ShiversVert/Snake_Project/ImageProcessing/image.jpg

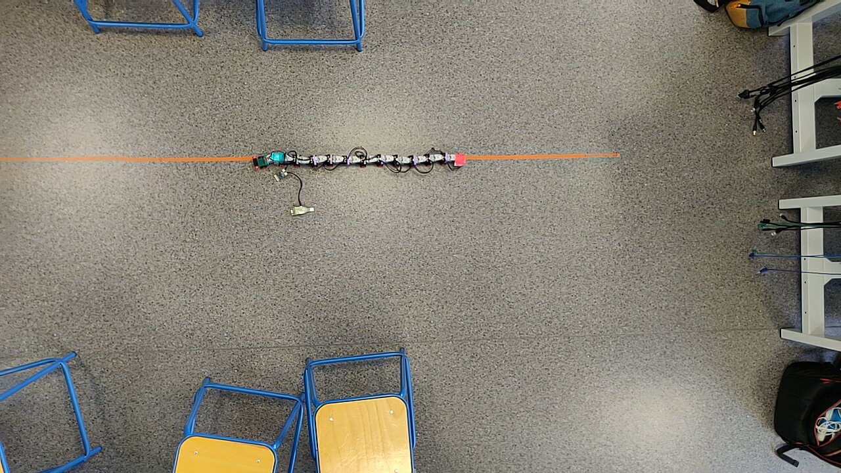
ImageProcessing/image.jpg
