ShiversVert/Snake_Project/Support_oneplus6t.stl

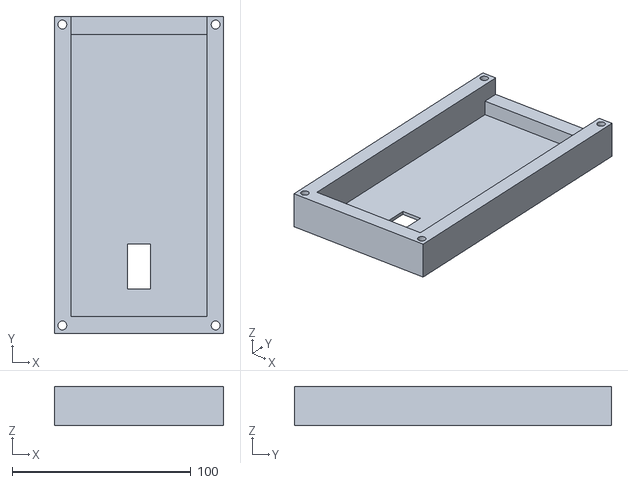
[picture p19: CAD file, 2019-05-06]
Support_oneplus6t.stl
94.8 x 177.5 x 22.0
