ShiversVert/Snake_Project/supp_tete_v2.stl

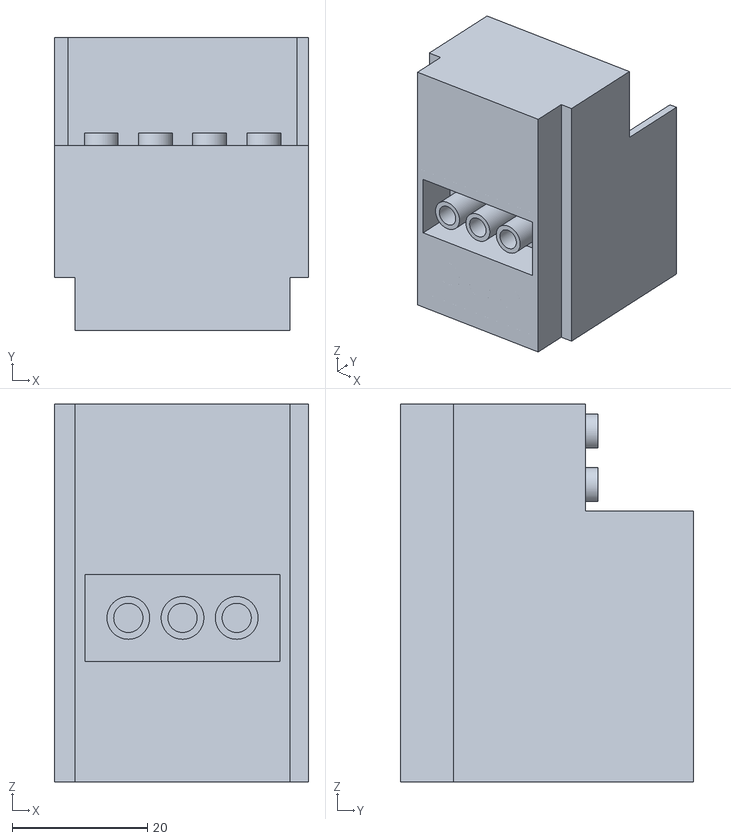
[picture p20: CAD file, 2019-05-06]
supp_tete_v2.stl
37.5 x 43.2 x 55.8
