ShiversVert/Snake_Project/piece_text_lego_v4.stl

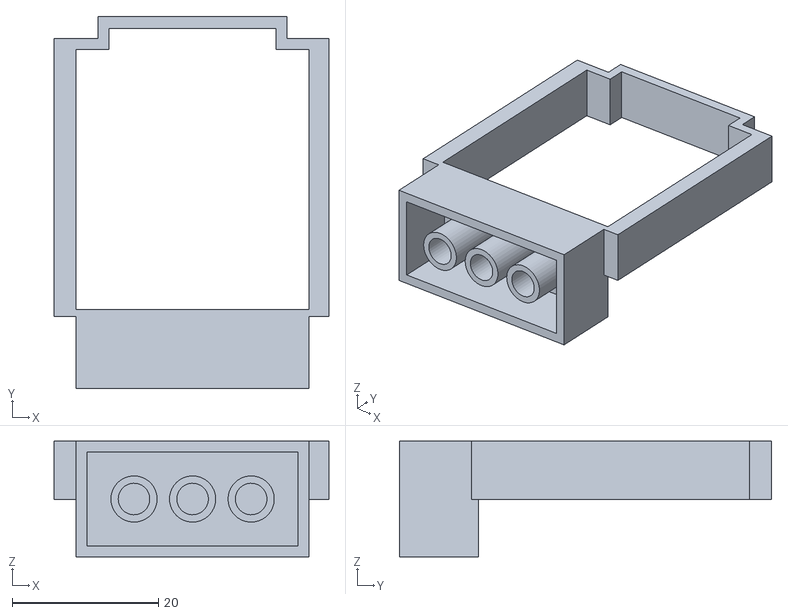
[picture p21: CAD file, 2019-05-06]
piece_text_lego_v4.stl
37.5 x 50.8 x 15.8
