ShiversVert/Snake_Project/servo_controlling/program/mapping_angle_offset.py

# -*- coding: utf-8 -*-

from time        import time, sleep
from math        import cos, sin, pi, atan
from pydynamixel import dynamixel, chain, registers

import pygame
from pygame.locals import *
"""
pygame.init()
pygame.font.init()
myfont = pygame.font.SysFont('Arial', 30)
fenetre = pygame.display.set_mode((640, 480))
"""
# TODO opti float()

# t = time()    # DEBUG
# for i in range(1000):
#     print (time() - t, "coucou{}".format(i))
#####  0.00276 sec  #####
# assert 0


############################

# You'll need to change this to the serial port of your USB2Dynamixel
serial_port = '/dev/ttyUSB0'
ser         = dynamixel.get_serial_for_url(serial_port)
# ser = dynamixel.get_serial_for_com(serial_port)    # DEBUG DEBUG


servo_id    = [1,2,3,4,5,6,7,8,9,10,11,12]

## Config servos movement ##
tick_period = 0.01              # Prediode de chaque instruction
sleep_time  = tick_period/10    # si utilisé, permet de réduire l'utilisation des
                                # ressources de la machine, mais ticks moins précis
resolution  = 500     # nombre de tick pour une période de la pos angu d'un servo
#Augmenter le resolution = ralentir

## Config snake waveform  ##
n_period    = 1     # nombre de "période" de l'ondulation du serpent
amplitude   = 300     # amplitude de l'ondulation du serpent  < 500
ANGLE_MAX   = 120     # angle crete crete max
turnOffset  = 0        # +-150

############################

move    = -1
offset  = 512+turnOffset
n_servo = len(servo_id)

# pré-calculs
mvt_speed      = 2 * pi * 1./resolution
amplitude_norm = amplitude * (float(n_period)/n_servo) * 1024./300.
omega          = 2 * pi *n_period/float(n_servo)


# enable write response
for n in range(n_servo):
    reg_value = registers.STATUS_RETURN.RETURN_FOR_ALL_PACKETS
    reg_addr  = registers.STATUS_RETURN_LEVEL  # /!\ /!\ WARNING marche uniquement sur 1 bytes !!!
                                               # goal position est sur 2 bytes !!!!
    dynamixel.set_reg_1b( ser, servo_id[n], reg_addr, reg_value, False )  # revoie pas de reponse
    print('Reg @{} set successfully at {} !'.format(reg_addr, reg_value) )

### Velocity settings ###
v = 400
velocity = [ v for i in range(n_servo) ]
sleep(0.1)
for n in range(n_servo):
    dynamixel.set_velocity(ser, servo_id[n] , velocity[n])
    #sleep(0.1)

# disable write response
for n in range(n_servo):
    reg_value = registers.STATUS_RETURN.RETURN_ONLY_FOR_READ
    reg_addr  = registers.STATUS_RETURN_LEVEL  # /!\ /!\ WARNING marche uniquement sur 1 bytes !!!
                                           # goal position est sur 2 bytes !!!!
    dynamixel.set_reg_1b(ser, servo_id[n], reg_addr, reg_value)  # revoie une reponse
    print('Reg @{} set successfully at {} !'.format(reg_addr, reg_value) )


# init position
goal_pos_vect = [ int( round( offset + amplitude_norm * cos( omega*n ) ) )    for n in range(n_servo) ]
# Angle safe check (can slow execution)
assert abs(max(goal_pos_vect)-offset) < 1024./300.*ANGLE_MAX , "Angle max (={}°) dépassé".format(ANGLE_MAX)
for n in range(n_servo):
    sleep(0.1)
    dynamixel.set_position_no_response( ser, servo_id[n], goal_pos_vect[n] )
dynamixel.send_action_packet( ser )


print("Commencer?")
a = raw_input()


t = time()
tick = 0
for i in range(1,2000):
    tick += move
    for n in range(n_servo):
        # dynamixel.set_position( ser, servo_id[n], goal_pos_vect[n] )
        dynamixel.set_position_no_response( ser, servo_id[n], goal_pos_vect[n] )

        print "    ", time()-t  # DEBUG
    dynamixel.send_action_packet( ser )
    print "  ", time()-t        # DEBUG

    # compute next goal position vector
    goal_pos_vect = [ int( round( offset + amplitude_norm * cos( omega*n + tick*mvt_speed ) ) )    for n in range(n_servo) ]
    # ne pas recréer la liste mais réécrire dedans pour opti ???

    # Angle safe check (can slow execution)
    assert abs(max(goal_pos_vect)-offset) < 1024./300.*ANGLE_MAX , "Angle max (={}°) dépassé".format(ANGLE_MAX)


    # Wait next tick
    while( time() < t+i*tick_period ):    # tick => i
        # pass
        '''
        if ( tick%10 == 0 ):
            for event in pygame.event.get():    #Attente des événements
                # if event.type == QUIT:
                #     continuer = 0

                if (event.type == KEYDOWN):
                    if   (event.key == K_UP   ):
                        move = min( move+1, 1)
                        textsurface = myfont.render("UP      => MOVE : {}           ".format(move), False, (255, 0, 255), (0,100,0) )
                        fenetre.blit(textsurface,(0,0))
                        pygame.display.flip()
                    elif (event.key == K_DOWN ):
                        move = max( move-1, -1)
                        textsurface = myfont.render("DOWN    => MOVE : {}           ".format(move), False, (255, 0, 255), (0,100,0) )
                        fenetre.blit(textsurface,(0,0))
                        pygame.display.flip()
                    elif (event.key == K_LEFT ):
                        if (offset > 460):
                            offset -= 5
                        textsurface = myfont.render("LEFT    => OFFSET : {}         ".format(offset), False, (255, 0, 255), (0,100,0) )
                        fenetre.blit(textsurface,(0,0))
                        pygame.display.flip()
                    elif (event.key == K_RIGHT):
                        if (offset < 564):
                            offset += 5
                        textsurface = myfont.render("RIGHT   => OFFSET : {}         ".format(offset), False, (255, 0, 255), (0,100,0) )
                        fenetre.blit(textsurface,(0,0))
                        pygame.display.flip()

        '''
        #sleep(sleep_time)   # utile si tick_period>0.001 ?
print( time()-t )  # DEBUG

print('Success!')
