ShiversVert/Snake_Project/(commit log)

2019-02-10 Premier fichiers de test
2019-02-12 Fonctionnement des fonctions de mask de pygame => On arrive a detecter les zones rouge et verte rapidement
2019-02-16 AJout d'une fonction pour estimer la courbe lineaire entre deux points
2019-02-16 AJout d'un programme pour gener aléatoirement des forme et detecter leur alignement
2019-02-19 Detection de l'alignement de 2 couleurs à partir d'une image prise par la camera
2019-02-26 ajout lib dynamixel et pydynamixel (mise au propre) + organisation de l'arborensce du projet
2019-03-19 ajout des programmes de traitement d'images
2019-03-26 Edition des fichier de traitement d'image
2019-03-26 Ajout d'un script permettant de mesurer l'angle de deviance du serpent enfonction de l'offset
2019-04-09 Travail sans colin et réorganisation des fichiers
2019-04-09 Creation d'une fonction permettant de gerer les servos
2019-04-09 mise en fct de mvt_serpent
2019-04-09 Ajout d'une TODO list pour la semaine suivante
2019-04-11 COmmencement de l'algorithme genetique
2019-04-11 Ecriture des fonctions permettant de mettre en place l'aglorithme génétique. TODO : Assembler ces fonctions pour le faire fonctionner
2019-04-11 Ajout d'une fonction pour sauvegarder une génération et modification de la fonction d'hybridation
2019-04-12 Ajout de quelques fonctions pour l'enregistrement et l'afficha des résultats. TODO : s'occuper de la fonction de score qui doit appeler les fonctions permettant de faire bouger le serpent
2019-04-13 Quelque modifications et commencement d'un fichier regrouppant les fonctions sur le traitement d'image
2019-04-13 Finalisation des fonctions de traitement d'image. TODO : calculer effectivement le score en fonction de l'elipse
2019-04-13 Redefinition de la fonction de d'evaluation d'un individu
2019-04-15 Mesure de la distance parcourue en 1200 ticks => ~850px Quelques corrections
    [genetic_algorithm.py, imageprocessing_functions.py]
2019-04-15 Mersure de la distace parcourue en 1200ticks => ~850px
2019-04-15 Debug des fonctions en cours
2019-04-16 Version provisoire de la fonction de score: distance à la cible
2019-04-18 Modification du nombre de tick etde la distance à parcourir : loi linéaire => 900 ticks = 637px
2019-04-18 Modificationde la fonction de save
2019-04-19 Déplacement des fichiers
2019-04-19 Fonction d'affichage du score des differentes generations en fonctions de leurs parametres
2019-05-02 Upload mechanical pieces
    [Support_oneplus6t.stl, piece_text_lego_v4.stl, supp_tete_v2.stl]
